HexabitzPlatform/H26R1x-Hardware/README.md

# H26R1x-Hardware
Hexabitz High-precision Load Cell and Thermocouple Interface Module Hardware Design
