HexabitzPlatform/H26R1x-Hardware/Released/BOM/H26R01.xlsx

 |  | www.hexabitz.com info@hexabitz.com |  |  | Bill Of Materials
Customer | Hexabitz | Revision | 1
Project | Hexabitz Modules | Date | 2023-06-04
Board | Wheatstone Bridge Load Cell (H26R01) | Notes
Designator | Description | Manufacturer Part Number | Manufacturer | Octopart Url | Quantity
RESET | PCB Header, Unshrouded, Thru 02 Straight Header, .101, AMPMODU Mod II Series | 87227-1 | TE Connectivity | https://octopart.com/87227-1-te+connectivity-39512052?r=sp | 1
SWD | Conn Unshrouded Header HDR 3 POS 2.54mm Solder ST Top Entry Thru-Hole Carton | 5-146281-3 | TE Connectivity | https://octopart.com/5-146281-3-te+connectivity+%2F+amp-39745942?r=sp | 1
S1 | 5pin Terminal Block; Printed Circuit; 10 A; 160 V; 3.5 mm; 5; 3.5 mm; 1.2 mm; M2; PA | 1984646 | Phoenix Contact | https://octopart.com/1984646-phoenix+contact-50274?r=sp&s=drI_GVM4QHaL48lSCATrxQ | 1
S2 | 2pin Terminal Block; Printed Circuit; 10 A; 160 V; 3.5 mm; 2; 3.5 mm; 1.2 mm; M2; PA | 1984617 | Phoenix Contact | https://octopart.com/1984617-phoenix+contact-58834?r=sp&s=Ef_UaV1JSFmY0wggQyN1Mw | 1
R1 | RES SMD 0.0OHM JUMPER 1/10W 0603 | RC0603JR-070RL | YAGEO [VR] | https://octopart.com/rc0603jr-070rl-yageo-1241539?r=sp | 1
R4, R5, R6, R7 | RES 100 OHM 5% 1/10W 0603 | RC0603JR-07100RL | Yageo | https://octopart.com/rc0603jr-07100rl-yageo-55458504?r=sp&s=j3XfnGiETZqzM9npqpV08Q | 4
R2 | Thick Film Resistors - SMD 0603 270 Ohm 5% Tol | ERJ-3GEYJ271V | Panasonic | https://octopart.com/erj-3geyj271v-panasonic-55560546?r=sp | 1
R3 | RES 10K Ohm 5% 0603 | CRCW060310K0JNEB | Vishay | https://octopart.com/crcw060310k0jneb-vishay-46603269 | 1
C1, C2, C4, C6, C8, C11, C12, C14, C15, C16 | CAP CER 0.1 UF 10% X7R 0603 | C0603C104K8RACTU | KEMET | https://octopart.com/c0603c104k8ractu-kemet-145075?r=sp&s=9bS9ASSwSEqMCE9KBEQZ0g | 10
C18 | CAP CER 1UF 10V X5R 0603 | GRM188R61A105KA61J | Murata | https://octopart.com/grm188r61a105ka61j-murata-9221870?r=sp&s=wvtiDxTpS1CkWsFaa2pliQ | 1
C5 | CAP CER 1 UF 16V X7R 0805 | CC0805KKX7R7BB105 | YAGEO [VA] | https://octopart.com/cc0805kkx7r7bb105-yageo-8376555?r=sp | 1
C7, C3 | CAP TANT 4.7 UF 10V 20% 0805 | 10TPU4R7MSI | Panasonic | https://octopart.com/10tpu4r7msi-panasonic-29487748?r=sp | 2
C9, C10, C13, C17, C19 | CAP CER 10UF 10V X5R 0603 | GRM188R61A106KE69D | Murata | https://octopart.com/grm188r61a106ke69d-murata-22851381?r=ap&s=o9t4ILLiSny6rfdd0oM5Kg | 5
FB1 | Ind chip Bead Multi-Layer 30 ohms 25% 100MHZ Ferrite 1,5A 0603Punched paper T/R | MMZ1608Y300BTA00 | TDK | https://octopart.com/mmz1608y300bta00-tdk-7906990?r=sp | 1
D1 | Red 0603 130° Clear 54 mcd 2 V Surface Mount ChipLED | VLMS1300-GS08 | Vishay | https://octopart.com/vlms1300-gs08-vishay-21709201?r=sp&s=0nXJNjGsSbWwqfqWlZv0EA | 1
U1 | MCU 32-Bit ARM Cortex-M0+ RISC 512kByte Flash 1.7V to 3.6V 48-Pin UFQFPN Tray | STM32G0B1CEU6N | STMicroelectronics | https://octopart.com/stm32g0b1ceu6n-stmicroelectronics-116364672?r=sp | 1
U2 | Switched Capacitor 5V Boost Converter 8-WSON -40 to 125 | LM2775QDSGRQ1 | Texas Instruments | https://octopart.com/lm2775qdsgrq1-texas+instruments-93339195?r=sp&s=OA7oim0HQqaBsU4tLKFWXg LM2775QDSGRQ1 | 1
U3 | 24-Bit Analog-to-Digital Converter (ADC) for Weigh Scales | HX711 | Avia Semiconductors | https://octopart.com/hx711-avia+semiconductor-106772965?r=sp&s=oPimE1kgSpuO9TK8ujI3IA# | 1
X1 | 8,0000MHZ 33pF SMD MURATA Resonators | CSTNE8M00G550000R0 | Murata | https://octopart.com/cstne8m00g550000r0-murata-91406934?r=sp | 1
