HexabitzPlatform/H26R1x-Hardware/Documentation/H26R01.pdf

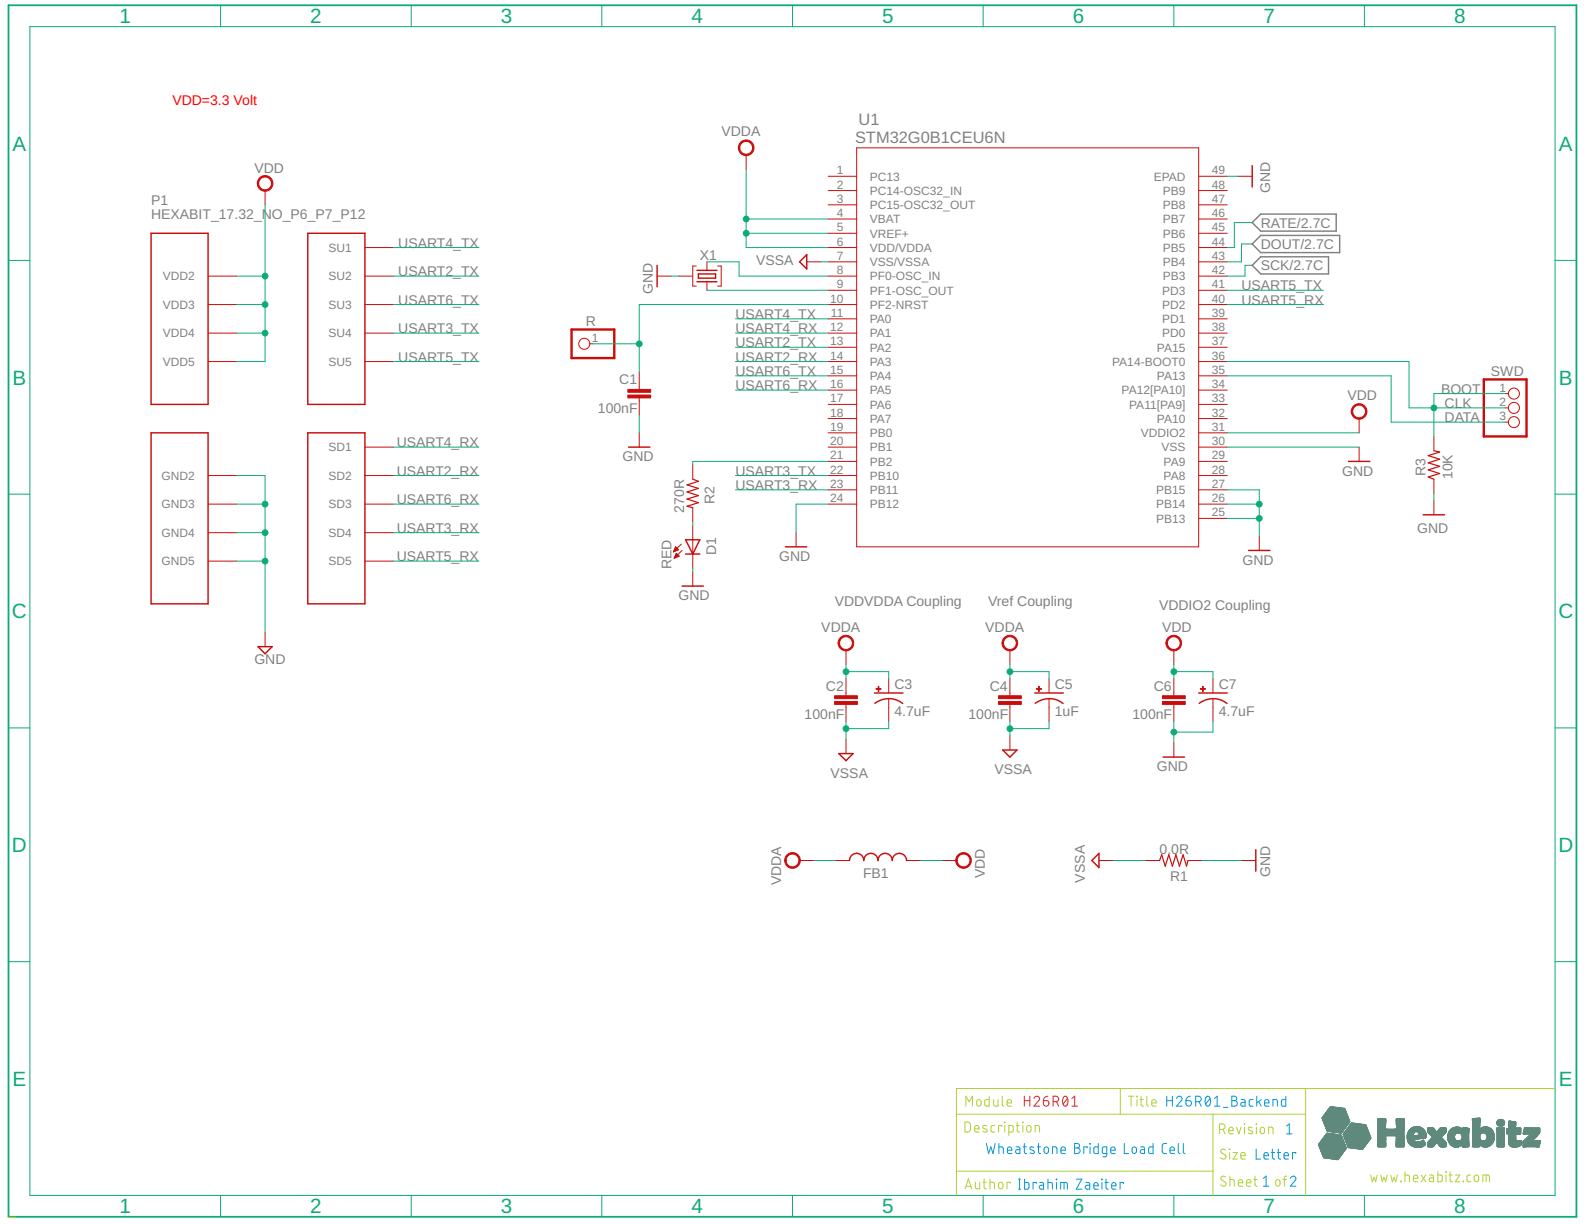
[picture p1: page 1]

5 | 45 PB7
6 | 44 PB6

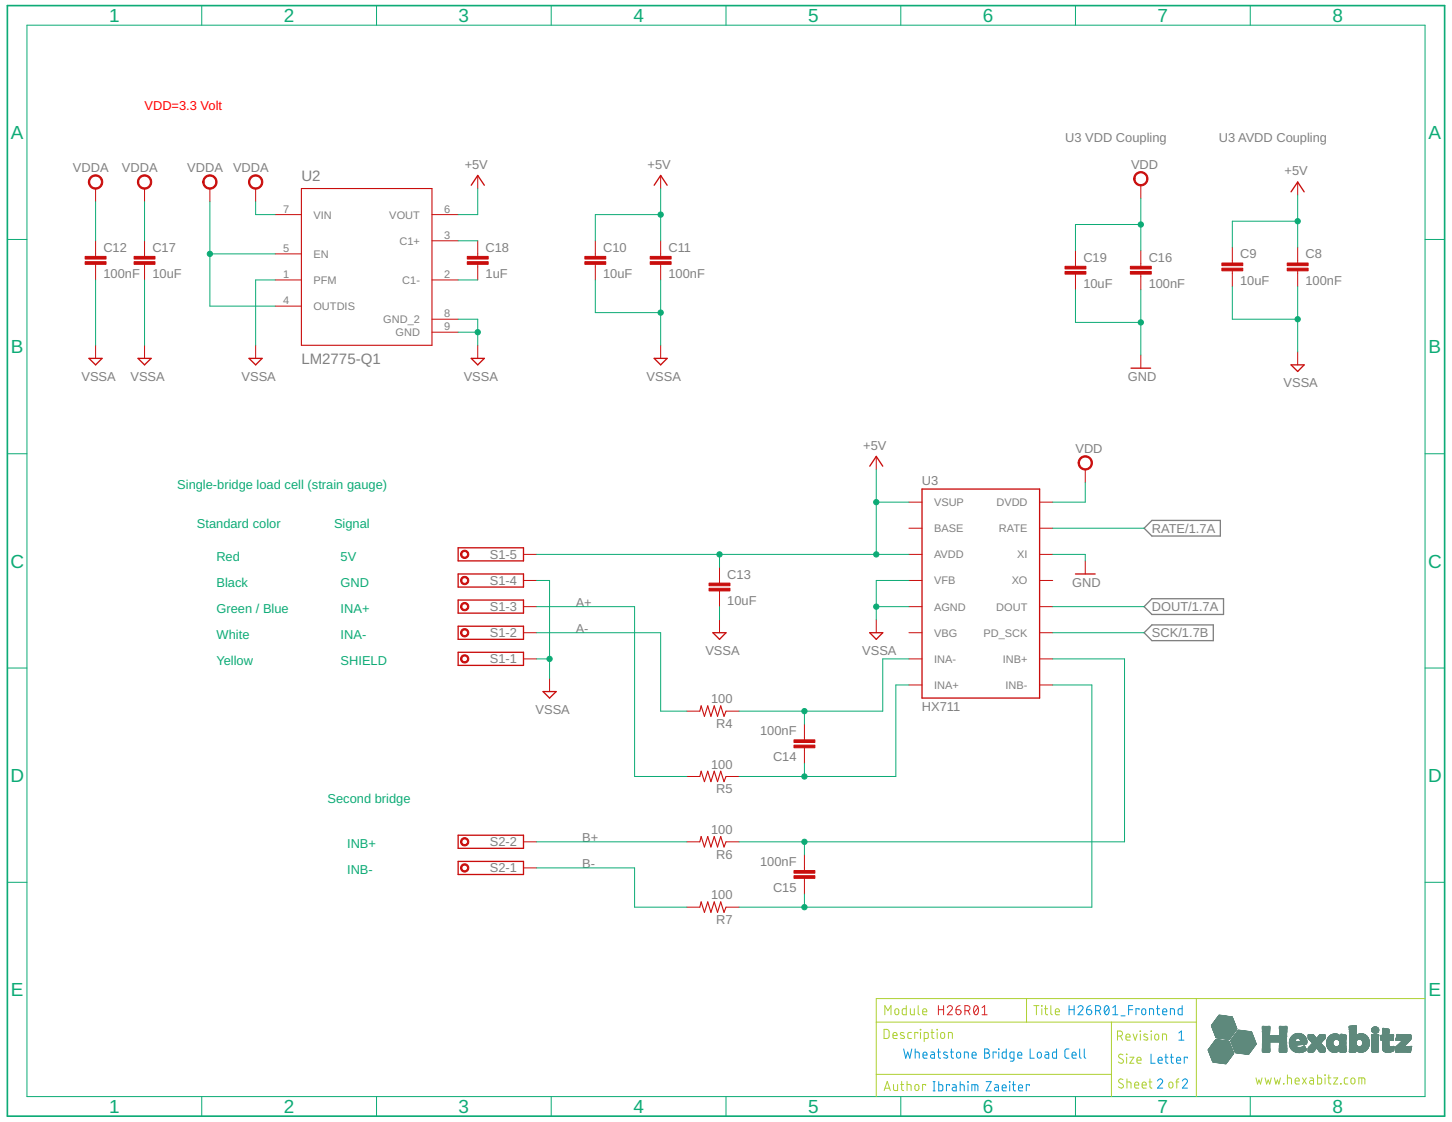
[picture p2: page 2]

Single-bridge load cell (strain gauge)

White Green / Blue Yellow
