HexabitzPlatform/H26R1x-Hardware/Design/H26R01.brd

## EAGLE design Design/H26R01.brd (2023-09-17)

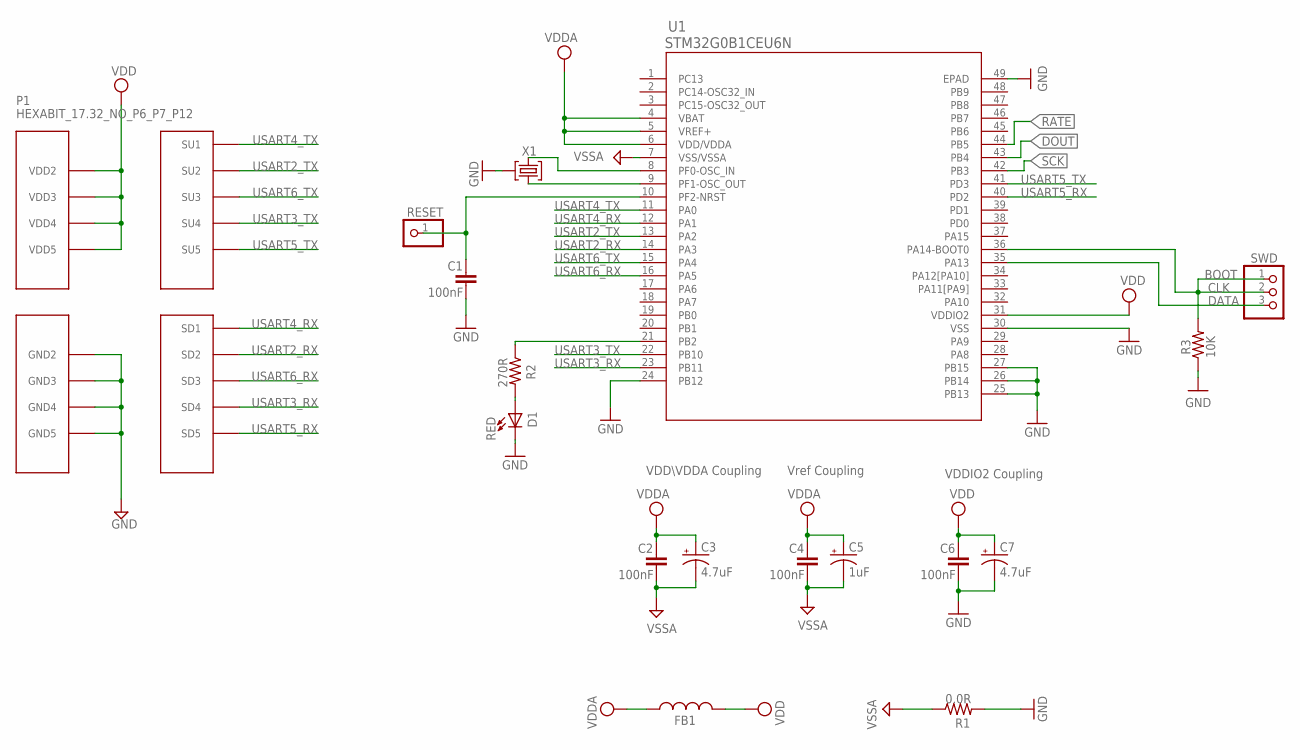
[picture p3: schematic H26R01.sch, sheet 1]

Parts:
C1, C2, C4, C6: 100nF; C-0603
C3, C7: 4.7uF; C-0805-POL
C5: 1uF; C-0805-POL
D1: RED; VLMS1300-GS08; MPN VLMS1300-GS08
FB1: FB-0603
P1: HEXABIT_17.32_NO_P6_P7_P12
R1: 0.0R; R-0603
R2: 270R; R-0603
R3: 10K; R-0603
RESET: R; 1X01
SWD: PINHD-1X3; 1X03
U1: STM32G0B1CEU6N; HEXABITZ_ICS_QFN_B1CEU6_STM-L
X1: XTALL_CSTCE8M00G52

Connections:
CLK: R3.2, SWD.1, SWD.2, U1.36 (PA14-BOOT0)
DATA: SWD.3, U1.35 (PA13)
DOUT: U1.43 (PB4); also elsewhere on the board
GND: C1.2, C6.2, C7.2 (-), D1.C, P1.PAD_PD8 (GND2), P1.PAD_PD9 (GND3), P1.PAD_PD10 (GND4), P1.PAD_PD11 (GND5), R1.2, R3.1, U1.24 (PB12), U1.25 (PB13), U1.26 (PB14), U1.27 (PB15), U1.30 (VSS), U1.49 (EPAD), X1.P$2 (2); also elsewhere on the board
unnamed: D1.A, R2.2
unnamed: R2.1, U1.21 (PB2)
unnamed: U1.9 (PF1-OSC_OUT), X1.P$1 (1)
unnamed: U1.8 (PF0-OSC_IN), X1.P$3 (3)
unnamed: C1.1, RESET.1, U1.10 (PF2-NRST)
RATE: U1.44 (PB5); also elsewhere on the board
SCK: U1.42 (PB3); also elsewhere on the board
USART2_RX: P1.PAD_PD2 (SD2), U1.14 (PA3)
USART2_TX: P1.PAD_PU2 (SU2), U1.13 (PA2)
USART3_RX: P1.PAD_PD4 (SD4), U1.23 (PB11)
USART3_TX: P1.PAD_PU4 (SU4), U1.22 (PB10)
USART4_RX: P1.PAD_PD1 (SD1), U1.12 (PA1)
USART4_TX: P1.PAD_PU1 (SU1), U1.11 (PA0)
USART5_RX: P1.PAD_PD5 (SD5), U1.40 (PD2)
USART5_TX: P1.PAD_PU5 (SU5), U1.41 (PD3)
USART6_RX: P1.PAD_PD3 (SD3), U1.16 (PA5)
USART6_TX: P1.PAD_PU3 (SU3), U1.15 (PA4)
VDD: C6.1, C7.1 (+), FB1.2, P1.PAD_PU8 (VDD2), P1.PAD_PU9 (VDD3), P1.PAD_PU10 (VDD4), P1.PAD_PU11 (VDD5), U1.31 (VDDIO2); also elsewhere on the board
VDDA: C2.1, C3.1 (+), C4.1, C5.1 (+), FB1.1, U1.4 (VBAT), U1.5 (VREF+), U1.6 (VDD/VDDA); also elsewhere on the board
VSSA: C2.2, C3.2 (-), C4.2, C5.2 (-), R1.1, U1.7 (VSS/VSSA); also elsewhere on the board

Notes on the sheet:
Vref Coupling
VDDIO2 Coupling
VDD\VDDA Coupling
BOOT

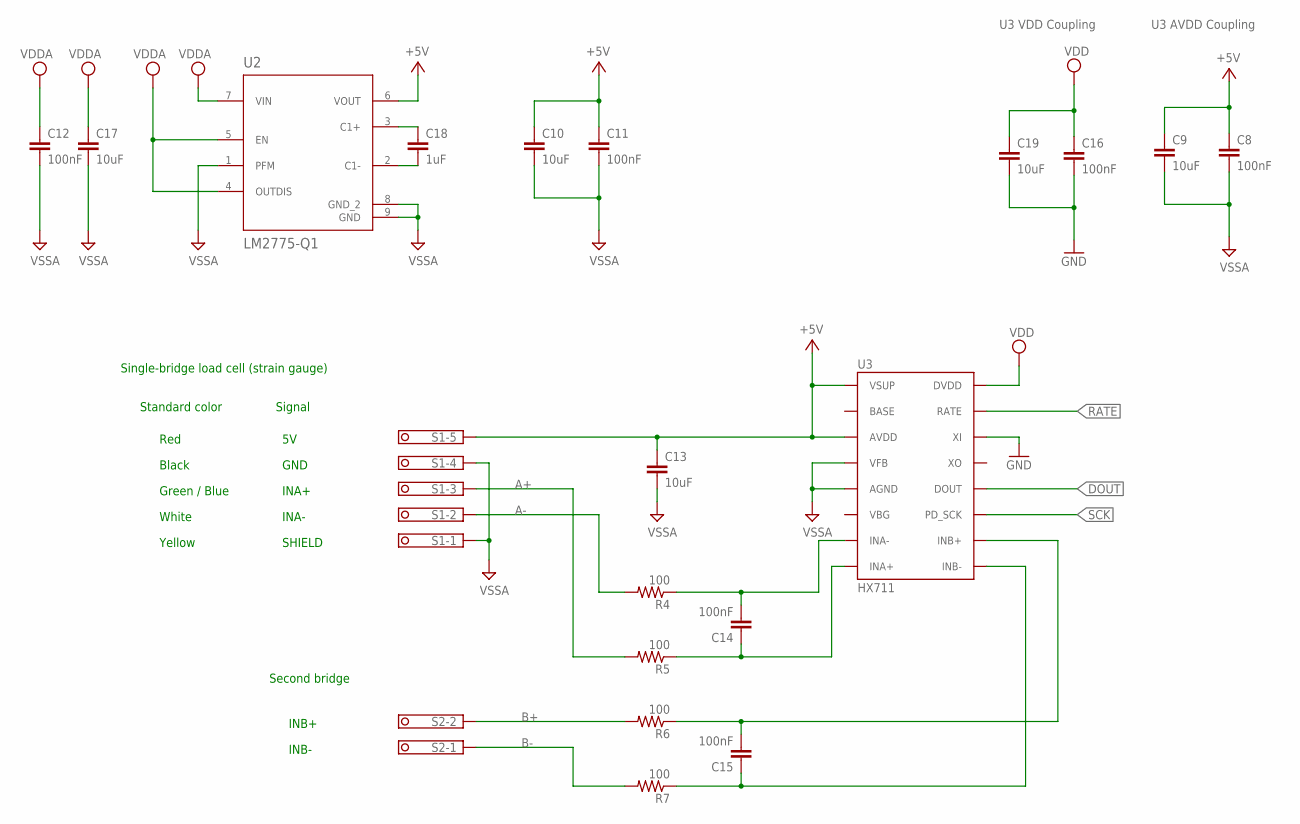
[picture p4: schematic H26R01.sch, sheet 2]

Parts:
C8, C11, C12, C16: 100nF; C-0603; TOLERANCE 10%; VOLTAGE_RATING 10V; MPN C0603C104K8RACTU
C9, C10, C13, C17, C19: 10uF; C-0603; TOLERANCE 10%; VOLTAGE_RATING 10V; MPN GRM188R61A106KE69D
C14, C15: 100nF; C-0603; TOLERANCE 10V; VOLTAGE_RATING 10%; MPN C0603C104K8RACTU
C18: 1uF; C-0603; TOLERANCE 10%; VOLTAGE_RATING 10V; MPN GRM188R61A105KA61J
R4, R5, R6, R7: 100; R-0603; TOLERANCE 5%; MPN RC0603JR-07100RL
S1: CON-PHOENIX-350_1751277; MPN 1984646
S2: CON-PHOENIX-350_1751248; MPN 1984617
U2: LM2775-Q1; DSG0008A
U3: HX711; HX711_SO16; MPN HX711

Connections:
+5V: C8.1, C9.1, C10.1, C11.1, C13.1, S1.5, U2.6 (VOUT), U3.1 (VSUP), U3.3 (AVDD)
A+: R5.2, S1.3
A-: R4.2, S1.2
B+: R6.2, S2.2
B-: R7.2, S2.1
DOUT: U3.12 (DOUT); also elsewhere on the board
GND: C16.2, C19.2, U3.14 (XI); also elsewhere on the board
INA+: C14.1, R5.1, U3.8 (INA+)
INA-: C14.2, R4.1, U3.7 (INA-)
INB+: C15.2, R6.1, U3.10 (INB+)
INB-: C15.1, R7.1, U3.9 (INB-)
unnamed: C18.1, U2.3 (C1+)
unnamed: C18.2, U2.2 (C1-)
RATE: U3.15 (RATE); also elsewhere on the board
SCK: U3.11 (PD_SCK); also elsewhere on the board
VDD: C16.1, C19.1, U3.16 (DVDD); also elsewhere on the board
VDDA: C12.1, C17.1, U2.4 (OUTDIS), U2.5 (EN), U2.7 (VIN); also elsewhere on the board
VSSA: C8.2, C9.2, C10.2, C11.2, C12.2, C13.2, C17.2, S1.1, S1.4, U2.1 (PFM), U2.8 (GND_2), U2.9 (GND), U3.4 (VFB), U3.5 (AGND); also elsewhere on the board

Notes on the sheet:
Standard color
Red
Black
White
Green / Blue
Yellow
Single-bridge load cell (strain gauge)
GND
INA-
INA+
SHIELD
Signal
INB-
INB+
Second bridge
U3 VDD Coupling
U3 AVDD Coupling

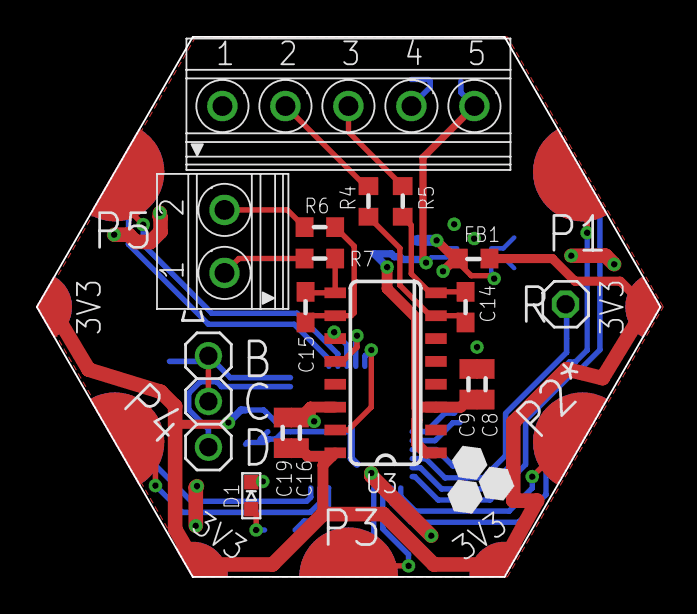
[picture p5: board H26R01.brd from above]

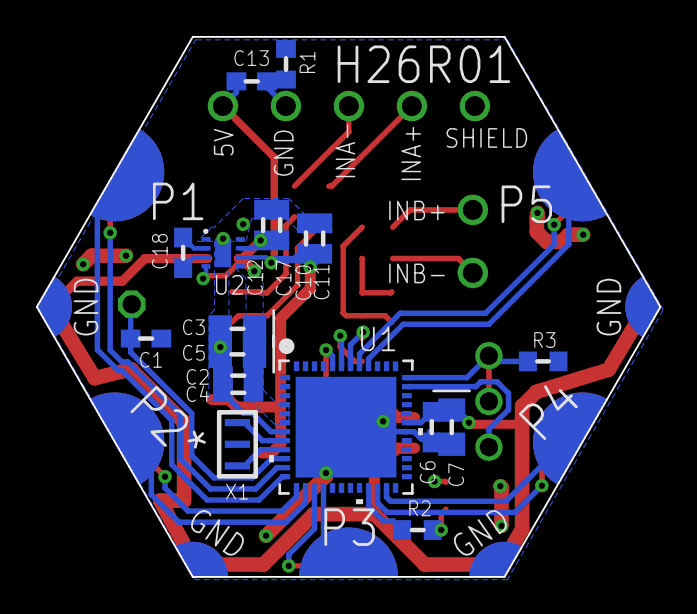
[picture p6: board H26R01.brd from below]

Board: 2 copper layers, 34.6 x 30.0 mm, 37 parts (19 on the bottom side), 35 nets.
