HexabitzPlatform/H26R1x-Hardware/(commit log)

2019-11-16 Adding template module generated from script + folders Updating schematics header Adding all AD components + analog input chain
    [H26R10.brd, H26R10.sch]
2019-11-18 Finished analog power chain and some AD8295 connections
    [H26R10.brd, H26R10.sch]
2019-11-21 Finished schematics. No ERC yet
    [H26R10.brd, H26R10.sch]
2019-11-22 Renumber schematics Arrange analong path in PCB to estimate footprint Replace module connector with double hexagon Need to replace MCU with bigger package to use 8 UARTs
    [H26R10.brd, H26R10.sch]
2019-11-25 Replace MCU with Add STM32F091RB (LQFP64) and connect UARTs
    [H26R10.brd, H26R10.sch]
2019-12-07 Rearrange uart connections Route analog section
    [H26R10.brd, H26R10.sch]
2019-12-07 More routing Add 2 more layers Add layer stack note
    [H26R10.brd, H26R10.sch]
2019-12-08 Finished routing Added polygons
    [H26R10.brd, H26R10.sch]
2019-12-08 arrange top silkscreen
    [H26R10.brd]
2019-12-10 Finished arranging silkscreen on top and bottom and added all ports, text etc
    [H26R10.brd]
2019-12-11 Finished routing and silkscreen.. Reviewed ERC and DRC PCB is done
    [H26R10.brd, H26R10.sch]
2019-12-12 Generate CAM files: gerber, drill, BOM, schematics and stack Update some components attributes Ready for release 1
    [H26R10.brd, H26R10.sch, H26R10.xlsx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]
2023-09-17 - Change the MCU to stm32g0b1ceu6n - Improve the hardware design - Do some changes in terminales naming
    [H26R01.brd, H26R01.sch, H26R01.xlsx, H26R10.brd, H26R10.sch, H26R10.xlsx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]
